KarlZeilhofer/WolkenThermometer-kicad/README.md

# WolkenThermometer - KiCad-Project

This repository contains the KiCad project of the WolkenThermometer. 
You can find here the bill of materials, the schematic and the board layout. 

Please refer to the project website
http://www.zeilhofer.co.at/wolke
