KarlZeilhofer/WolkenThermometer-kicad/pdf-2015-04-08-bw/wifi-sensor.pdf

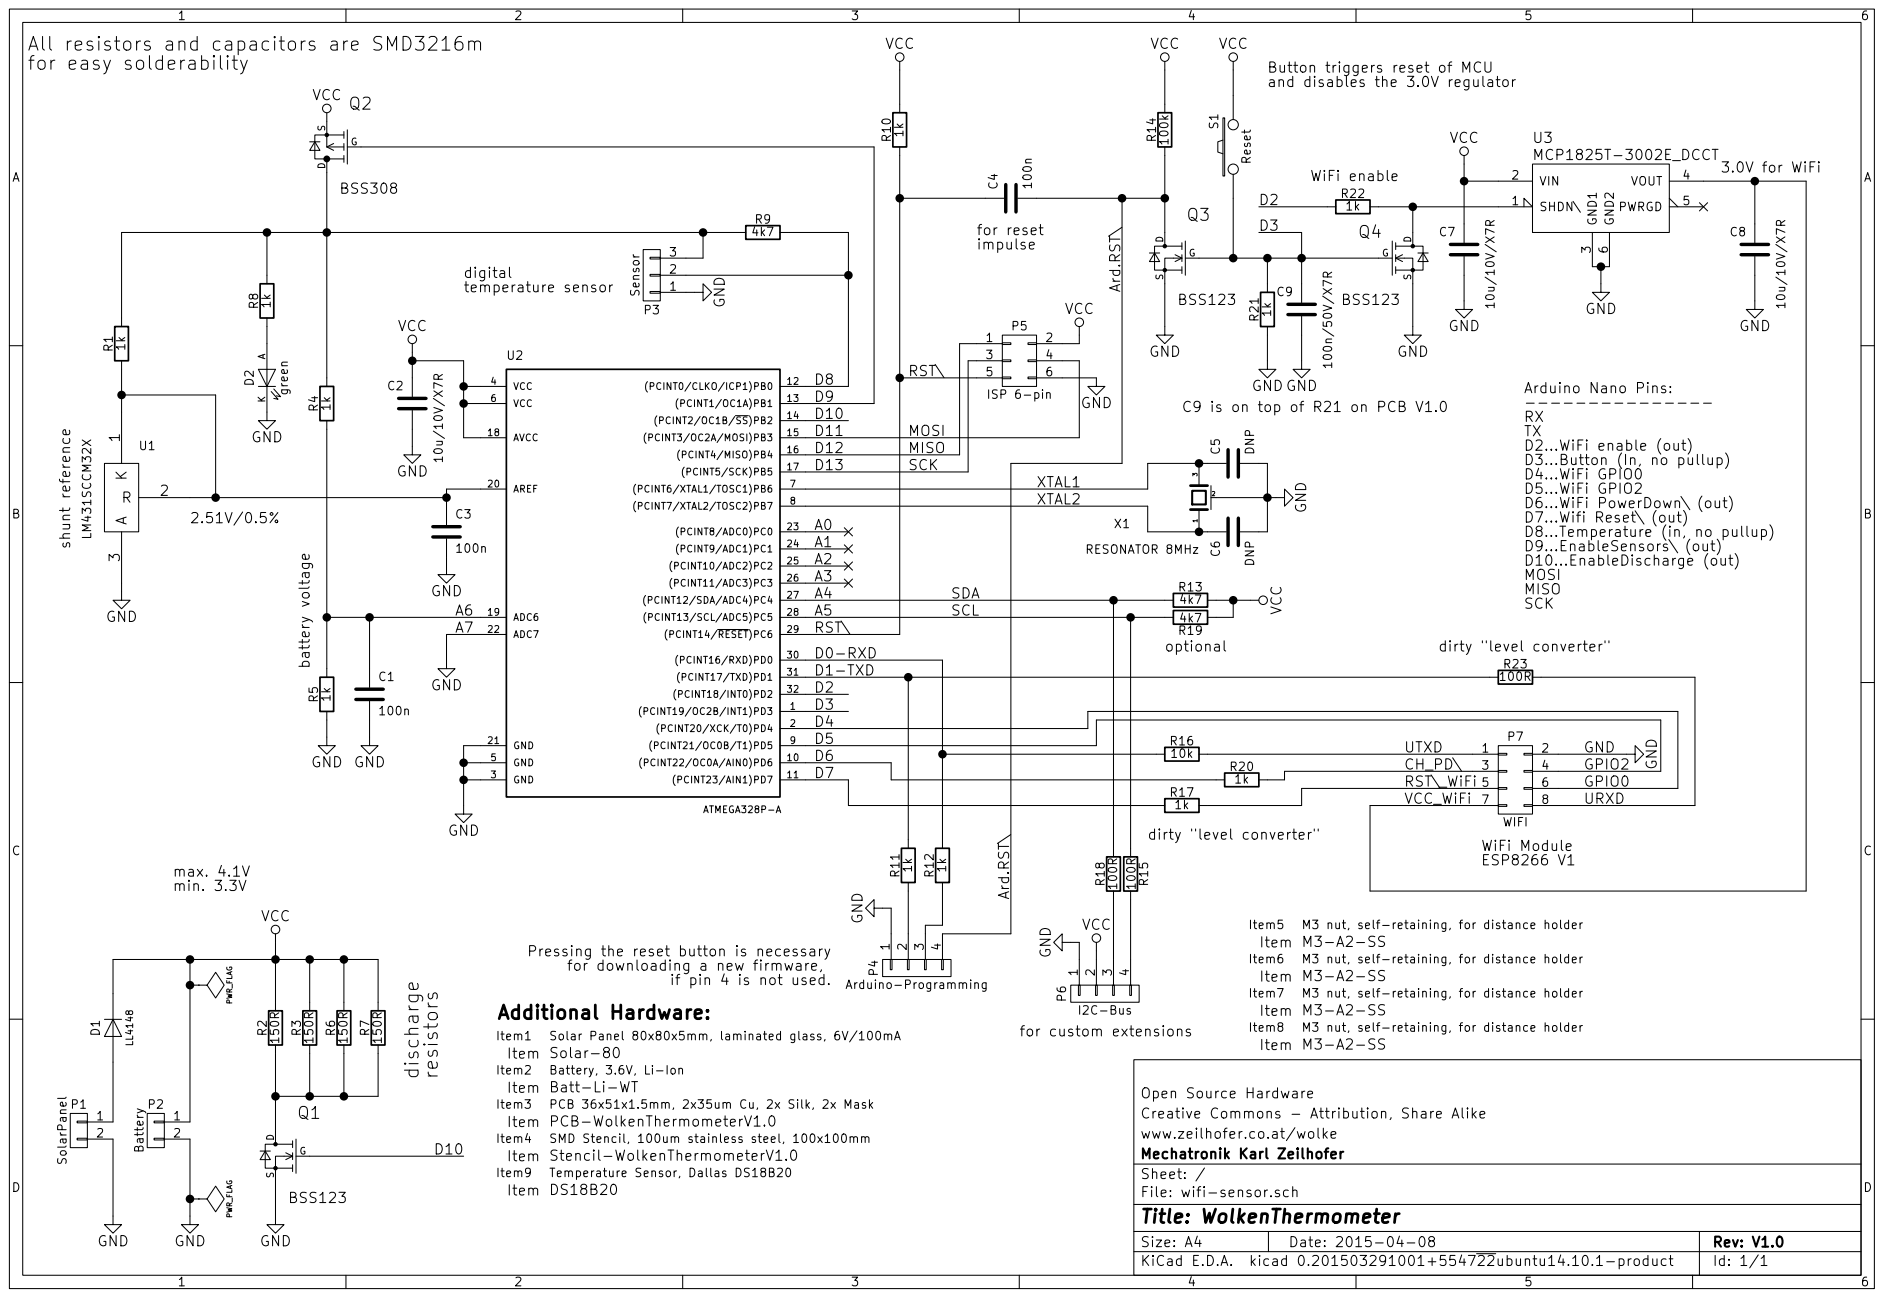
[picture p1: page 1]

All resistors and capacitors are SMD3216m

VCC
Button triggers reset of MCU

and disables the 3.0V regulator K

Arduino Nano Pins: --------------- RX

C9 is on top of R21 on PCB V1.0

TXD2...WiFi enable (out)
D3...Button (In, no pullup)
D4...WiFi GPIO0
D5...WiFi GPIO2
D6...WiFi PowerDown\ (out)
D7...Wifi Reset\ (out)
D8...Temperature (in, no pullup)
D9...EnableSensors\ (out)
D10...EnableDischarge (out)
MOSI
MISO
SCK

Pressing the reset button is necessary
for downloading a new firmware,

if pin 4 is not used.

Open Source Hardware
Id: 1/1 Title: WolkenThermometer File: wifi-sensor.sch Sheet: / Mechatronik Karl Zeilhofer www.zeilhofer.co.at/wolke Creative Commons - Attribution, Share Alike
