KarlZeilhofer/WolkenThermometer-kicad/wifi-sensor.kicad_pcb

## KiCad design wifi-sensor.kicad_pcb (2015-04-07)

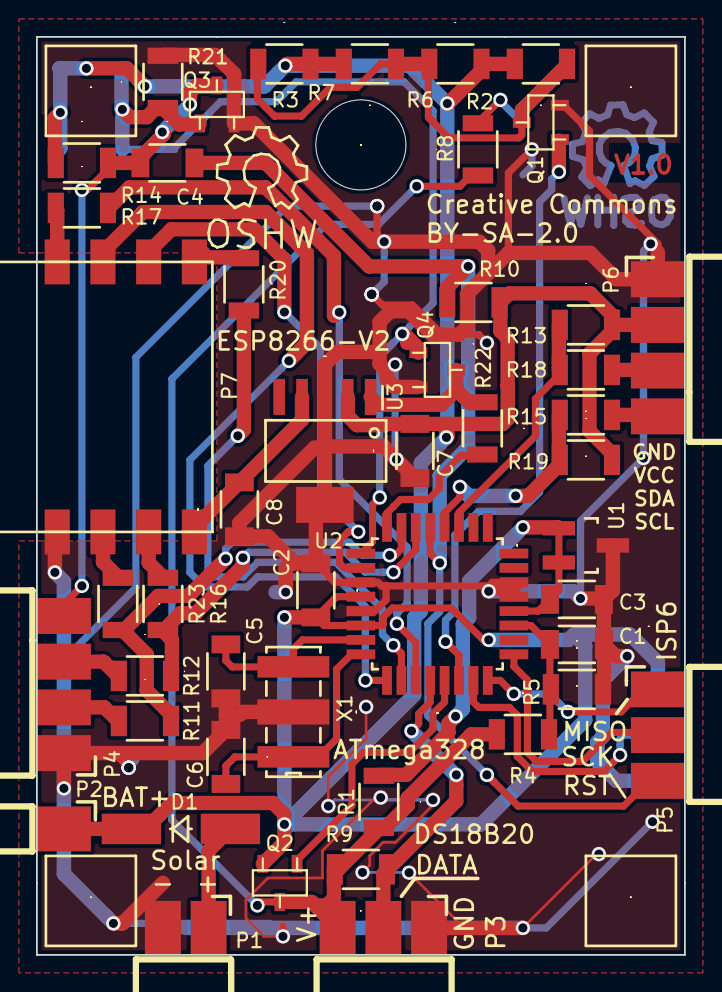
[picture p2: board wifi-sensor.kicad_pcb from above]

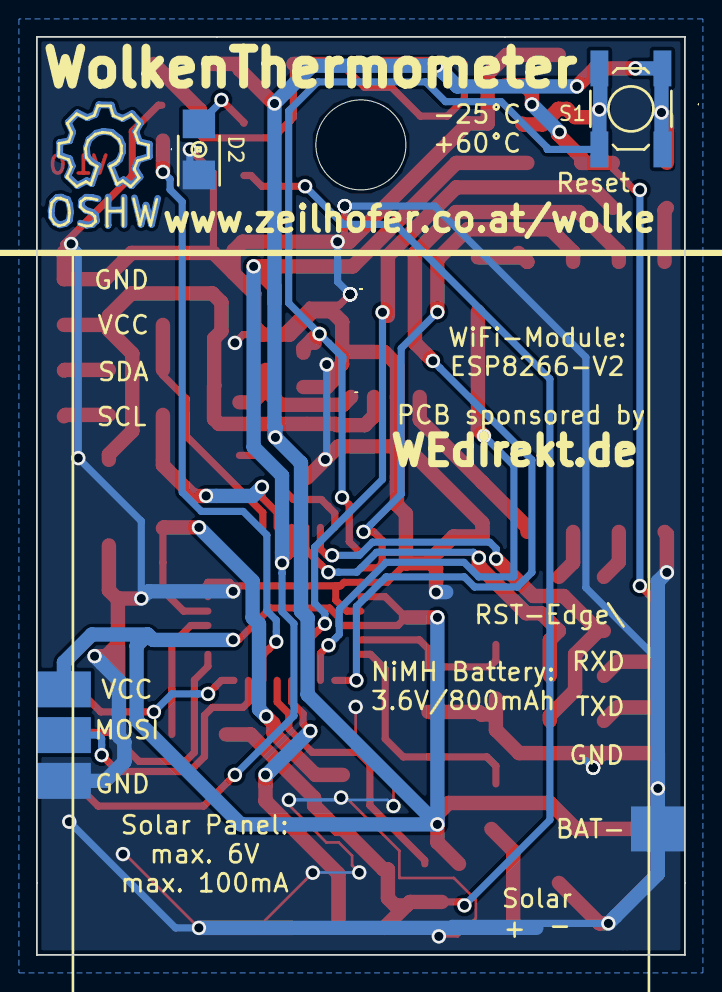
[picture p3: board wifi-sensor.kicad_pcb from below]

Board: 2 copper layers, 36.0 x 51.0 mm, 59 parts (6 on the bottom side), 38 nets.

Parts:
BAT1: 3.6V/800mAh/NiMH; Battery-Pack-3xAAA
C1, C3, C4: 100n; C_1206
C2, C7, C8: 10u/10V/X7R; C_1206
C5, C6: DNP; C_1206
D1: LL4148; Diode-MiniMELF_Handsoldering
D2: green; LED-1206
Drill-5mm: VAL**; Drill-5mm
G1: Solar Panel 6V/0.5W; Solar-Panel_60x60mm
P1: SolarPanel; Pinheader_01x02_Edge_SMT
P2: Battery; Pinheader_02x01_Edge_SMT
P3: DS18S20; Pinheader_01x03_Edge_SMT
P4: Arduino-Programming; Pinheader_01x04_Edge_SMT
P5: ISP 6-pin; Pinheader_02x03_Edge_SMT
P6: I2C-Bus; Pinheader_01x04_Edge_SMT
P7: WIFI; ESP8266-V2
Q1, Q3, Q4: BSS123; sot23-gsd
Q2: BSS308; sot23-gsd
R1, R4, R5, R8, R10, R11, R12, R17, R20, R22, R23: 1k; R_1206
R2, R3, R6, R7: 150R; R_1206
R9, R18, R19: 4k7; R_1206
R13, R15: 100R; R_1206
R14, R21: 100k; R_1206
R16: 10k; R_1206
Ref**: Holzfuß; Holzfuss
Ref**#2, Ref**#3, Ref**#4: Holzfuß; Holzfuss
S1: Reset; Switch_SMT_TL3315
Symbol_OSHW-Logo_CopperTop: VAL**; Symbol_OSHW-Logo_CopperTop
Symbol_OSHW-Logo_SilkScreen: VAL**; Symbol_OSHW-Logo_SilkScreen
Symbol_OSHW-Logo_SilkScreen#2: VAL**; Symbol_OSHW-Logo_SilkScreen
U1: LM431SCCM32X; SOT23_Handsoldering
U2: ATMEGA328P-A; TQFP-32_7x7mm_Pitch0.8mm
U3: MCP1825T-3002E_DCCT; SOT-223-5_1.27mm-pitch
X1: RESONATOR 8MHz; Resonator_7.2x3mm

Connections:
/A4: R13.1, R18.2, U2.27
/A5: R15.1, R19.2, U2.28
/A6: C1.1, R4.1, R5.2, U2.19
/Ard.RST\: C4.2, P4.4, Q3.D, R14.1
/CH_PD\: P7.3, R20.2
/D2: R22.1, U2.32
/D3: Q3.G, Q4.G, R21.2, S1.1, U2.1
/D4: P7.6, U2.2
/D5: P7.4, U2.9
/D6: R20.1, U2.10
/D7: R17.1, U2.11
/D8: P3.2, R9.2, U2.12
/D9: Q2.G, U2.13
/D10: Q1.G, U2.14
/D11: P5.4, U2.15
/D12: P5.1, U2.16
/D13: P5.3, U2.17
/RST\: C4.1, P5.5, R10.1, U2.29
/RST\_WiFi: P7.5, R17.2
/RXD: R12.1, R16.1, U2.30
/TXD: R11.1, R23.1, U2.31
/URXD: P7.8, R23.2
/UTXD: P7.1, R16.2
/VCC_WiFi: C8.1, P7.7, U3.4
/XTAL1: C5.1, U2.7, X1.3
/XTAL2: C6.1, U2.8, X1.1
GND: C1.2, C2.2, C3.2, C5.2, C6.2, C7.2, C8.2, D2.K, P1.2, P2.2, P3.1, P4.1, P5.6, P6.1, P7.2, Q1.S, Q3.S, Q4.S, R5.1, R21.1, U1.3, U2.3, U2.5, U2.21, U2.22, U3.3, U3.6, X1.2
unnamed: C3.1, R1.2, U1.1, U1.2, U2.20
unnamed: D1.A, P1.1
unnamed: D2.A, R8.1
unnamed: P3.3, Q2.D, R1.1, R4.2, R8.2, R9.1
unnamed: P4.2, R11.2
unnamed: P4.3, R12.2
unnamed: P6.3, R13.2
unnamed: P6.4, R15.2
unnamed: Q1.D, R2.2, R3.2, R6.2, R7.2
unnamed: Q4.D, R22.2, U3.1
VCC: C2.1, C7.1, D1.K, P2.1, P5.2, P6.2, Q2.S, R2.1, R3.1, R6.1, R7.1, R10.2, R14.2, R18.1, R19.1, S1.2, U2.4, U2.6, U2.18, U3.2
