KarlZeilhofer/WolkenThermometer-kicad/(threads)

Thread 2 (2015-04-08):

Pin-1 marks on connectors too close to the pad

KarlZeilhofer, 2015-04-08:
the silk screen marks get removed in production preparations.

Thread 3 (2015-04-08):

use different reset-button in next batch

KarlZeilhofer, 2015-04-08:
the current button is not intended to be used for direct access.

(DE: beim Prototyp kam es vor, dass die Betätigungskuppe, die nur mit einer Klebefolie fixiert ist, verloren gegangen ist. )
